fxliang/planck4x6/top_case.FCStd

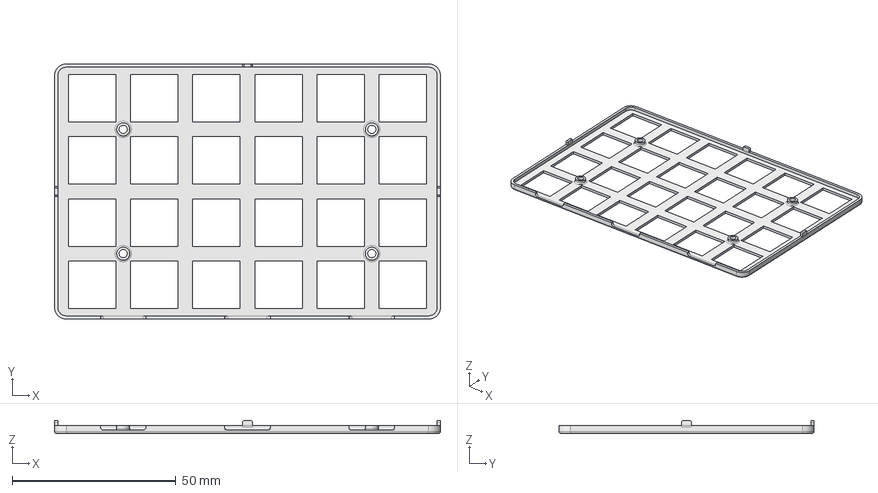
[picture p1: CAD file, 2023-02-18]
top_case.FCStd
118.0 x 78.0 x 3.90 mm
