fxliang/planck4x6/bottom_case.FCStd

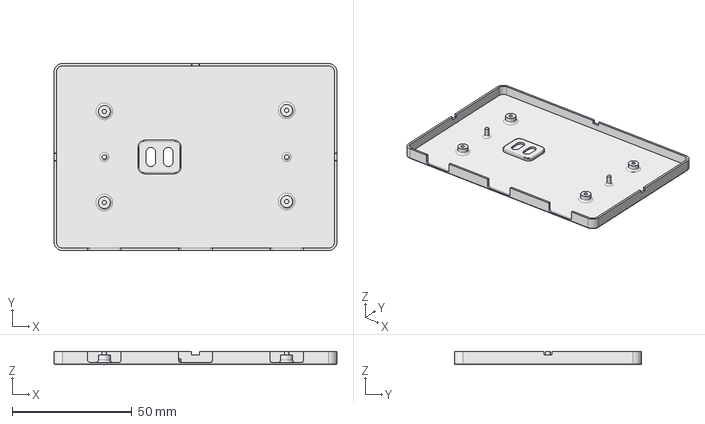
[picture p2: CAD file, 2023-02-18]
bottom_case.FCStd
118.0 x 78.0 x 5.60 mm
