fxliang/planck4x6/DHN-02F.STEP

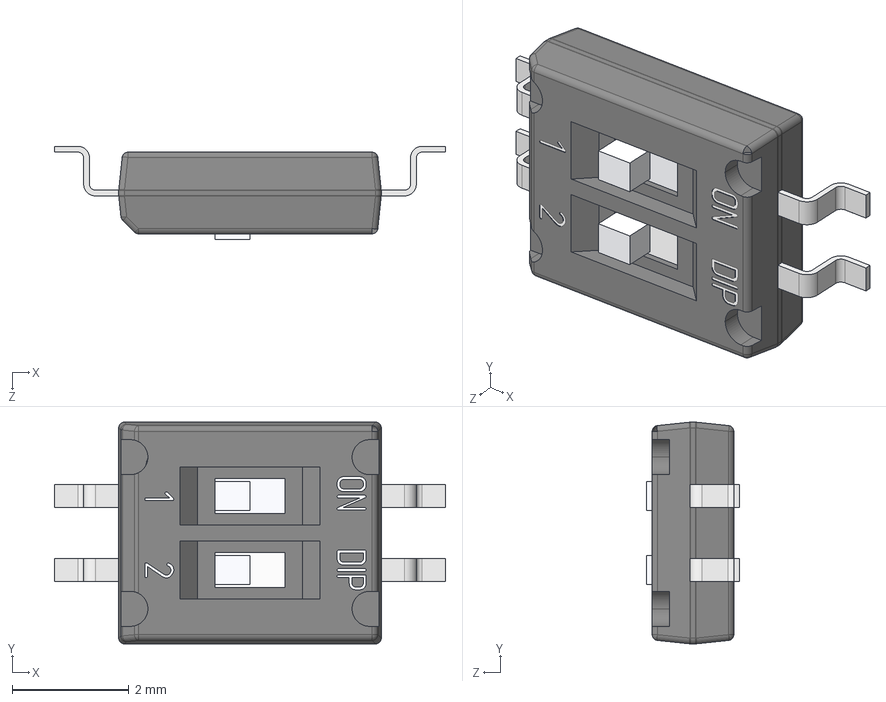
[picture p3: CAD file, 2023-02-17]
DHN-02F.STEP
6.70 x 3.80 x 1.60 mm
Open_CASCADE_STEP_translator_6.8_25.1
Open_CASCADE_STEP_translator_6.8_25.2.1
Leader x 4
