fxliang/planck4x6/MBK_Keycap_-_1u.step

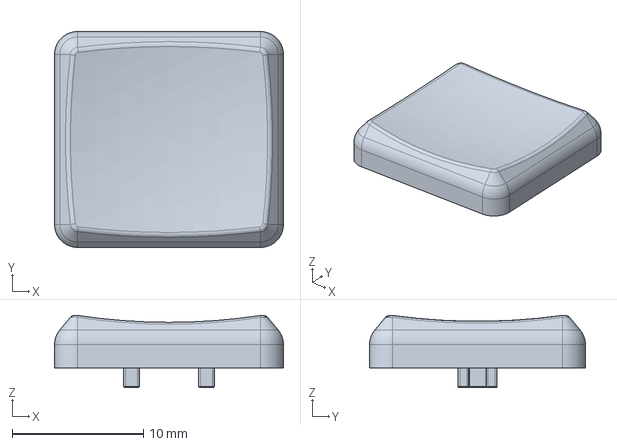
[picture p4: CAD file, 2023-02-17]
MBK_Keycap_-_1u.step
17.4 x 16.4 x 5.52 mm
