fxliang/planck4x6/SW_SPST_B3U-1000P.step

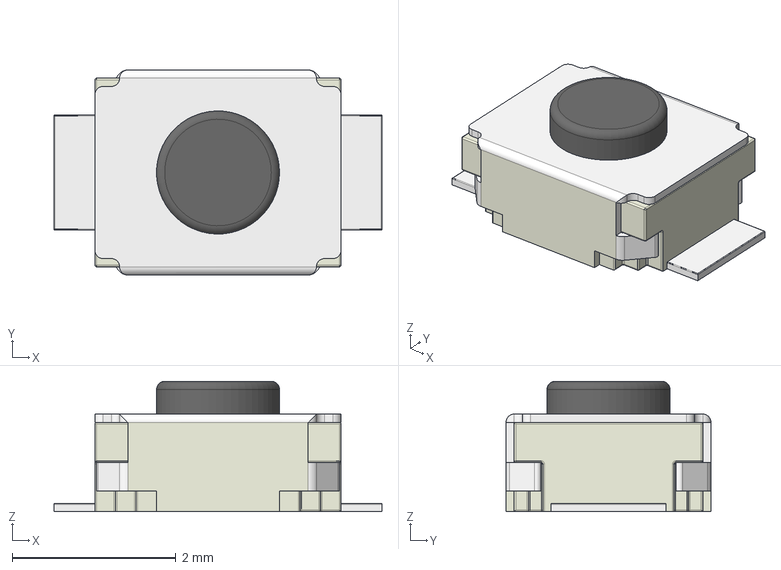
[picture p5: CAD file, 2023-02-17]
SW_SPST_B3U-1000P.step
4.00 x 2.50 x 1.59 mm
