fxliang/planck4x6/WS2812B.STEP

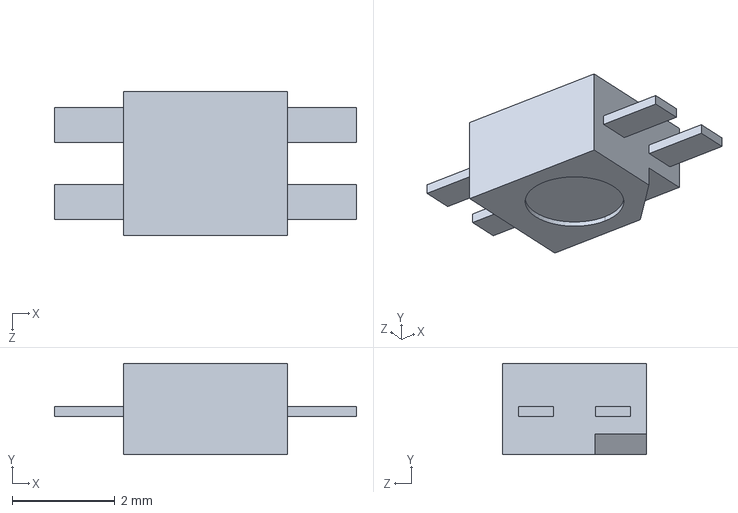
[picture p6: CAD file, 2023-02-13]
WS2812B.STEP
5.88 x 1.78 x 2.80 mm
