fxliang/planck4x6/TYPE-C-31-M-14.step

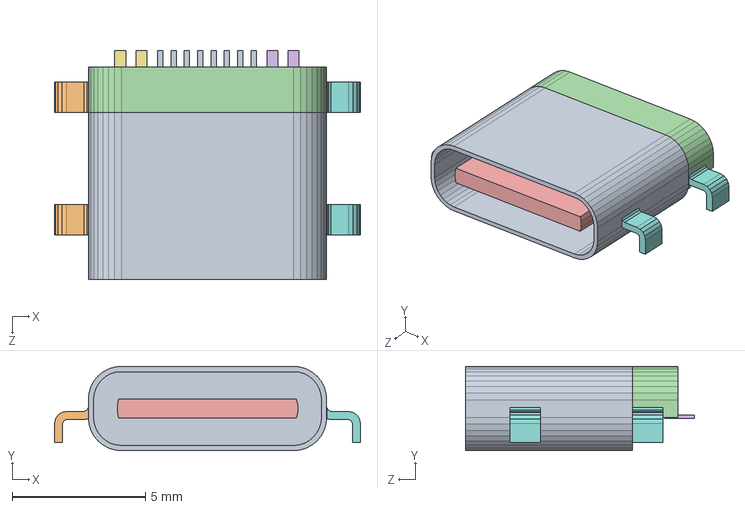
[picture p7: CAD file, 2023-02-10]
TYPE-C-31-M-14.step
11.5 x 3.16 x 8.58 mm
