fxliang/planck4x6/USON-8_3x2x0_55mm.STEP

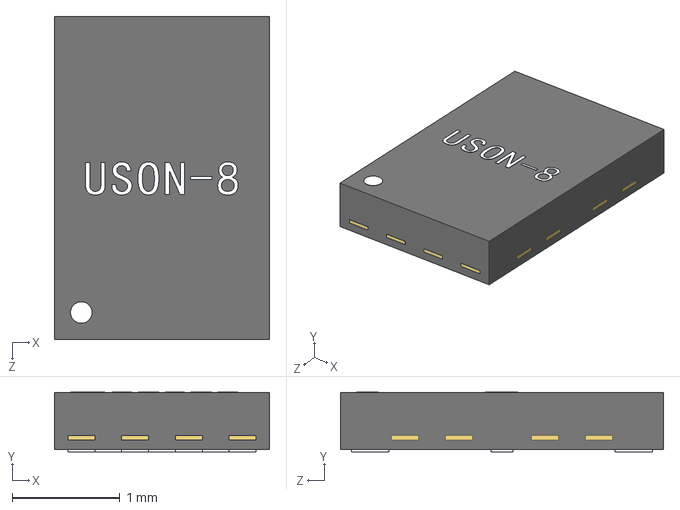
[picture p8: CAD file, 2023-02-10]
USON-8_3x2x0_55mm.STEP
2.00 x 0.553 x 3.00 mm
