fxliang/planck4x6/Switch_4x4x1.5MM.step

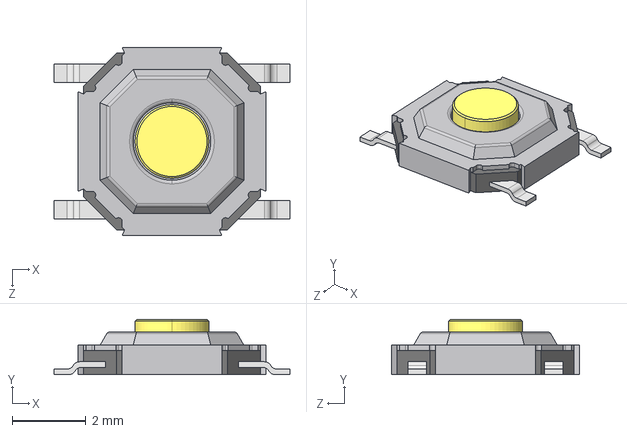
[picture p9: CAD file, 2023-02-10]
Switch_4x4x1.5MM.step
6.40 x 1.50 x 5.10 mm
