fxliang/planck4x6/C128990.STEP

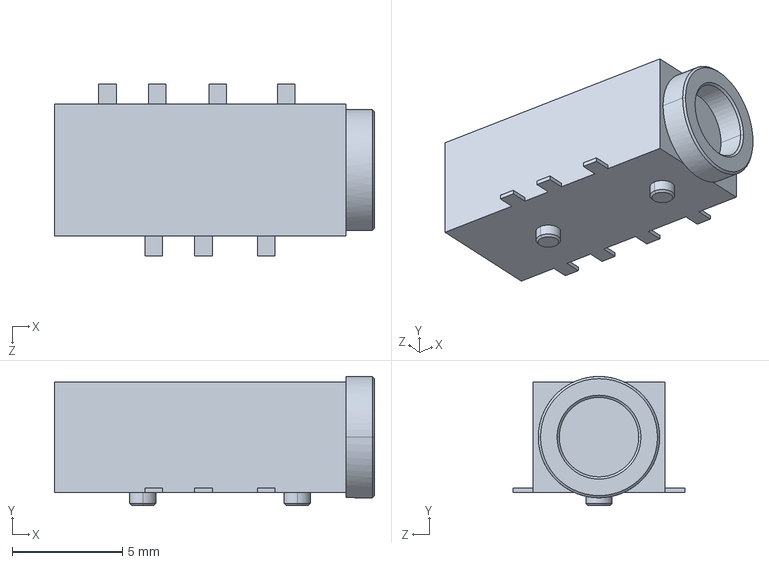
[picture p10: CAD file, 2023-02-07]
C128990.STEP
14.5 x 5.85 x 7.80 mm
