fxliang/planck4x6/(list of files, cad)

Other CAD files:
top_case-Part.step
bottom_case-Part.step
