fxliang/planck4x6/1457707425261.pdf

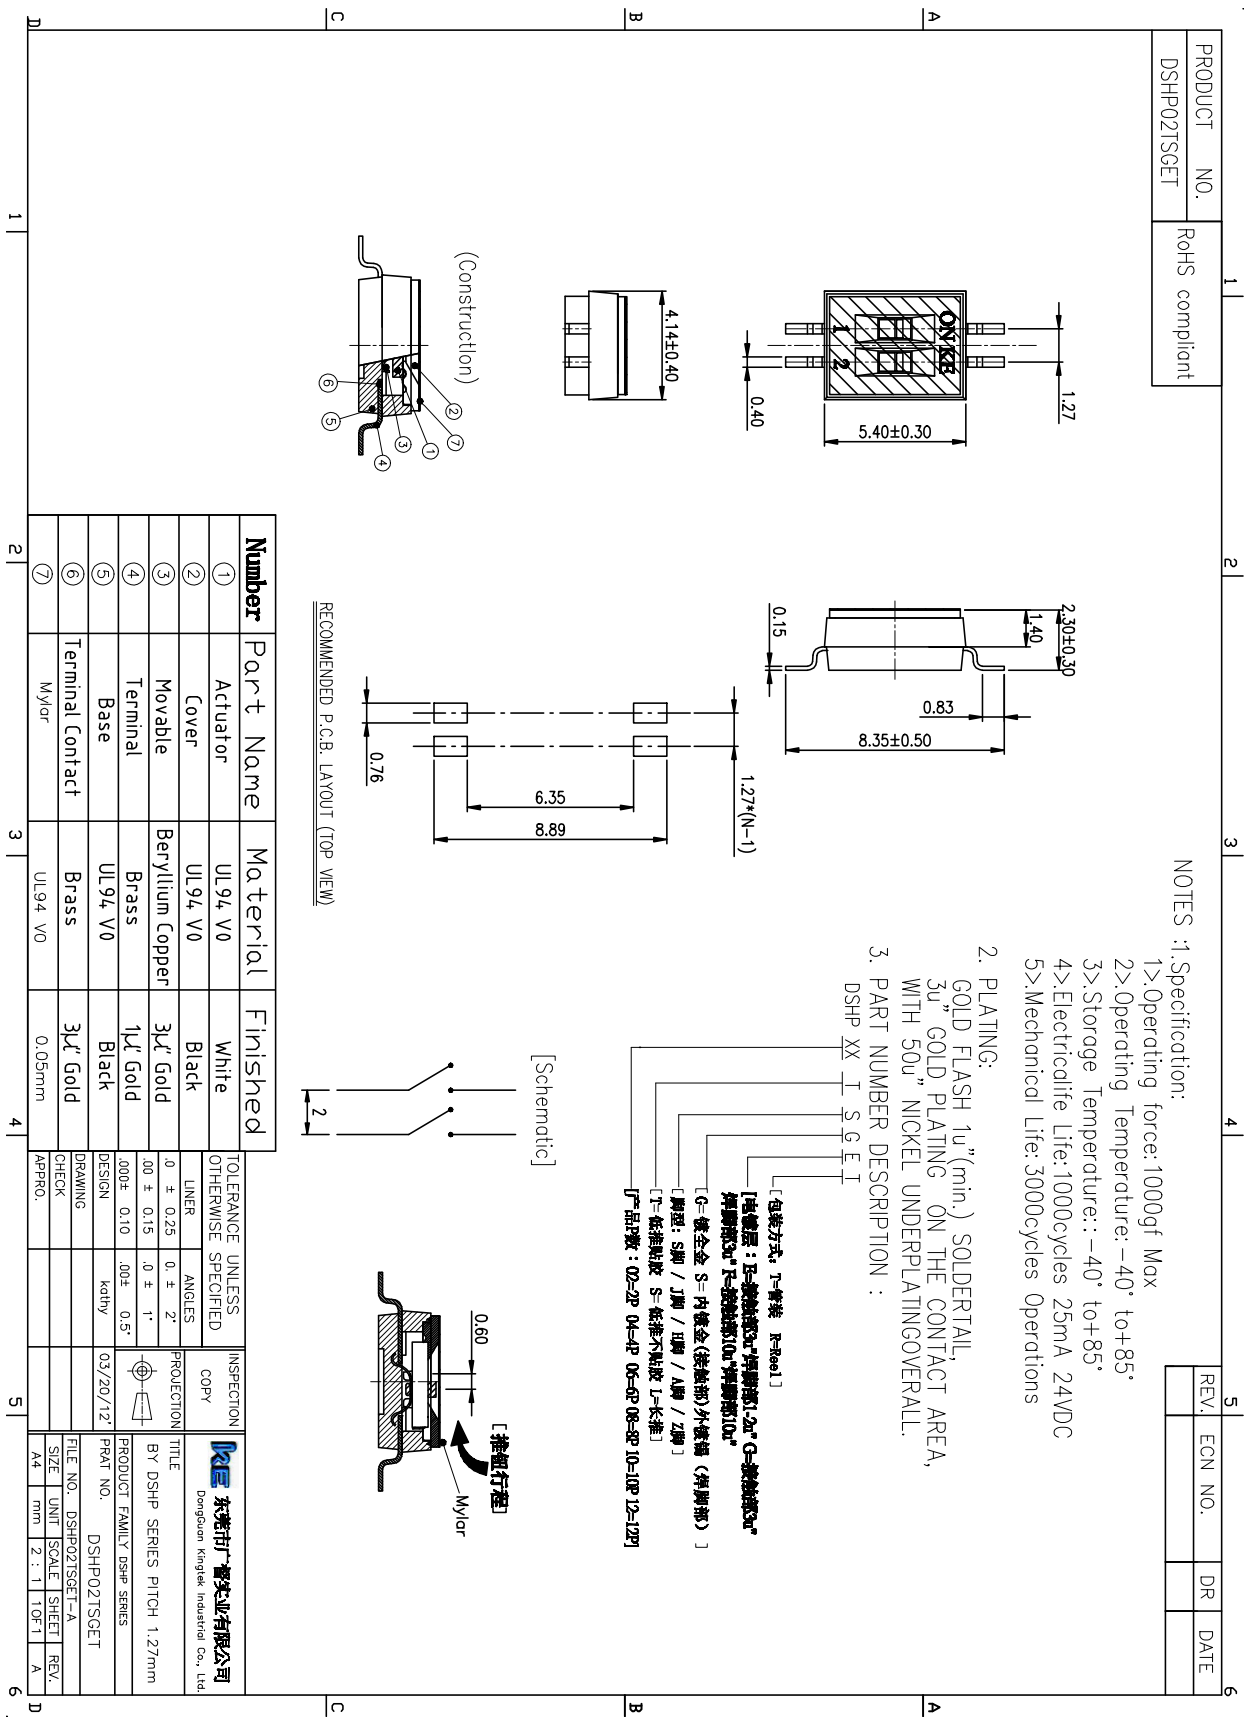
[picture p11: page 1]
