fxliang/planck4x6/planck.kicad_pcb

## KiCad design planck.kicad_pcb (2023-02-23)

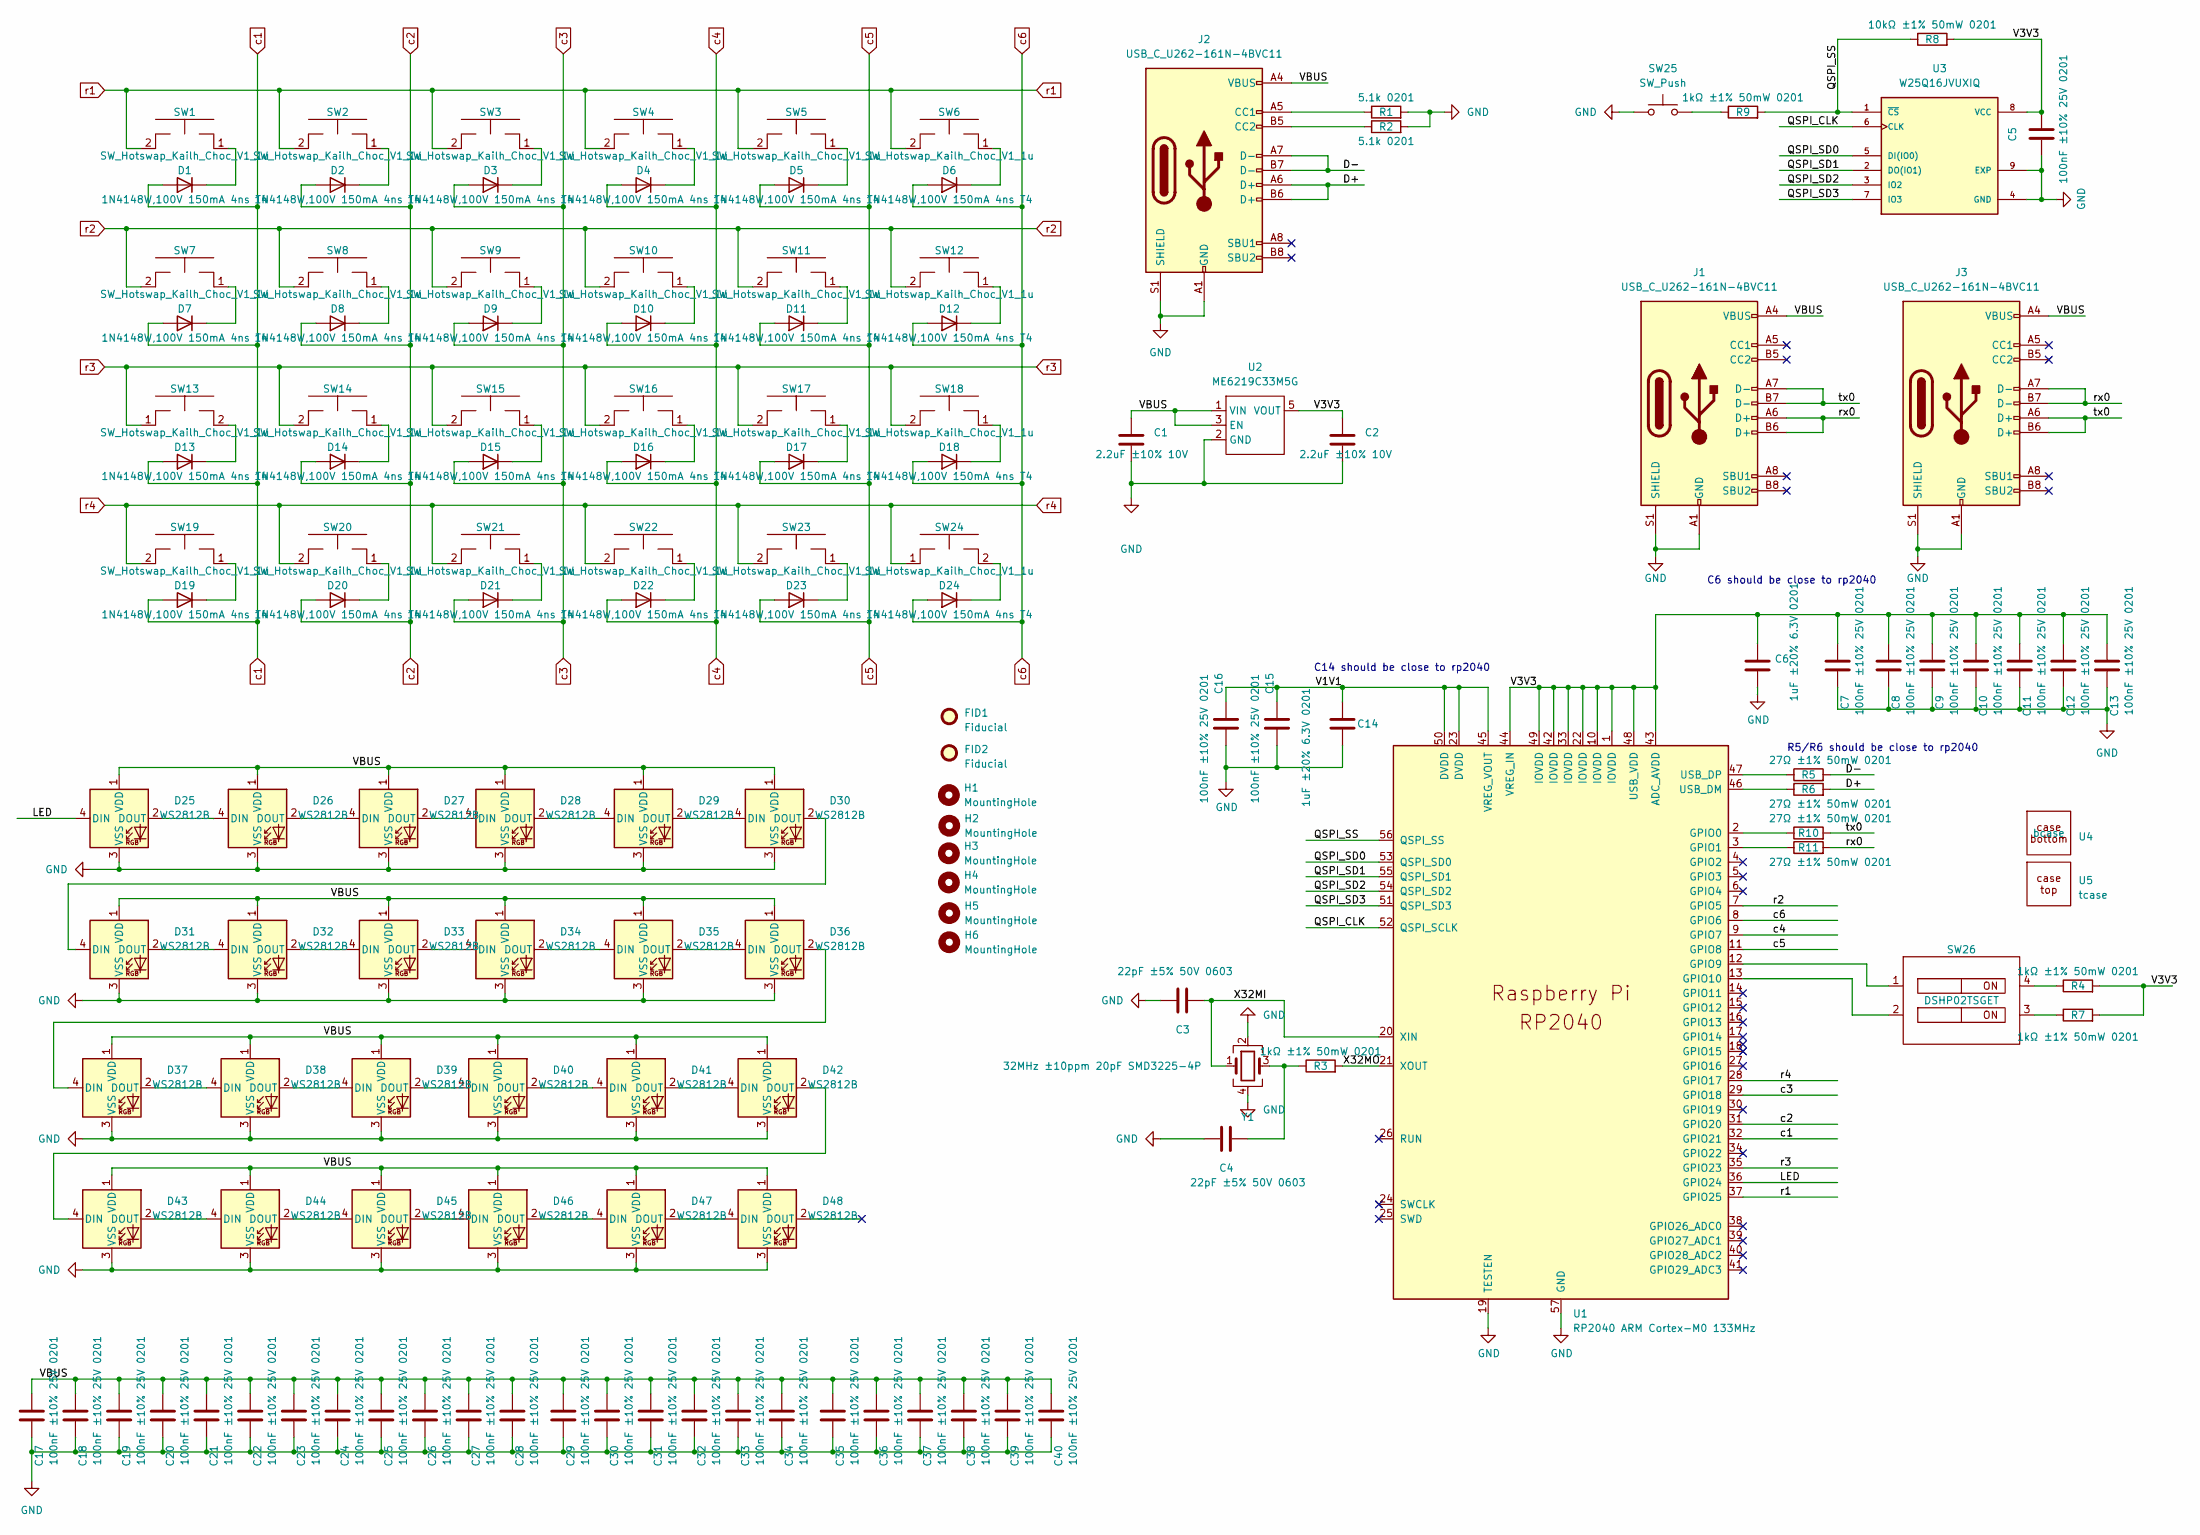
[picture p12: schematic planck.kicad_sch]

Parts:
C1, C2: 2.2uF ±10% 10V; R_0201_0603Metric; JLC C335106
C3, C4: 22pF ±5% 50V 0603; R_0201_0603Metric; JLC C76960
C5, C7, C8, C9, C10, C11, C12, C13, C15, C16, C17, C18, C19, C20, C21, C22, C23, C24, C25, C26, C27, C28, C29, C30, C31, C32, C33, C34, C35, C36, C37, C38, C39, C40: 100nF ±10% 25V 0201; R_0201_0603Metric; JLC C76939
C6, C14: 1uF ±20% 6.3V 0201; C_0201_0603Metric; JLC C87143
D1, D2, D3, D4, D5, D6, D7, D8, D9, D10, D11, D12, D13, D14, D15, D16, D17, D18, D19, D20, D21, D22, D23, D24: 1N4148W,100V 150mA 4ns T4; D_SOD-123; JLC C2099
D25, D26, D27, D28, D29, D30, D31, D32, D33, D34, D35, D36, D37, D38, D39, D40, D41, D42, D43, D44, D45, D46, D47, D48: WS2812B; WS2812_6028_REV_S
FID1, FID2: Fiducial; Fiducial_0.5mm_Mask1.5mm
H1, H2, H3, H4, H5, H6: MountingHole; MountingHole_2.2mm_M2
J1, J2, J3: USB_C_U262-161N-4BVC11; USB_C_TYPE-C-31-M-14; MPN U262-161N-4BVC11; JLC C223907
R1, R2: 5.1k 0201; R_0201_0603Metric; JLC C473460
R3, R4, R7, R9: 1kΩ ±1% 50mW 0201; R_0201_0603Metric; JLC C138165
R5, R6, R10, R11: 27Ω ±1% 50mW 0201; R_0201_0603Metric; JLC C273268
R8: 10kΩ ±1% 50mW 0201; R_0201_0603Metric; JLC C106225
SW1, SW2, SW3, SW4, SW5, SW6, SW7, SW8, SW9, SW10, SW11, SW12, SW13, SW14, SW15, SW16, SW17, SW18, SW19, SW20, SW21, SW22, SW23, SW24: SW_Hotswap_Kailh_Choc_V1_1u; SW_Hotswap_Kailh_Choc_V1
SW25: SW_Push; B3U-1000P; JLC C231329
SW26: DSHP02TSGET; JLC C40735
U1: RP2040 ARM Cortex-M0 133MHz; RP2040-QFN-56; JLC C2040
U2: ME6219C33M5G; SOT-23-5; JLC C47382
U3: W25Q16JVUXIQ; SON-8-1EP_3x2mm_P0.5mm_EP1.4x1.6mm; JLC C2843335
U4: bcase
U5: tcase
Y1: 32MHz ±10ppm 20pF SMD3225-4P; Crystal_SMD_3225-4Pin_3.2x2.5mm; JLC C164054

Connections:
/D+: J2.A6 (D+), J2.B6 (D+), R6.2
/D-: J2.A7 (D-), J2.B7 (D-), R5.2
/LED: D25.4 (DIN), U1.36 (GPIO24)
/QSPI_CLK: U1.52 (QSPI_SCLK), U3.6 (CLK)
/QSPI_SD0: U1.53 (QSPI_SD0), U3.5 (DI(IO0))
/QSPI_SD1: U1.55 (QSPI_SD1), U3.2 (DO(IO1))
/QSPI_SD2: U1.54 (QSPI_SD2), U3.3 (IO2)
/QSPI_SD3: U1.51 (QSPI_SD3), U3.7 (IO3)
/QSPI_SS: R8.1, R9.2, U1.56 (QSPI_SS), U3.1 (~CS)
/V1V1: C14.2, C15.1, C16.1, U1.23 (DVDD), U1.45 (VREG_VOUT), U1.50 (DVDD)
/V3V3: C2.1, C5.2, C6.1, C7.2, C8.2, C9.2, C10.2, C11.2, C12.2, C13.2, R4.2, R7.2, R8.2, U1.1 (IOVDD), U1.10 (IOVDD), U1.22 (IOVDD), U1.33 (IOVDD), U1.42 (IOVDD), U1.43 (ADC_AVDD), U1.44 (VREG_IN), U1.48 (USB_VDD), U1.49 (IOVDD), U2.5 (VOUT), U3.8 (VCC)
/VBUS: C1.1, C17.2, C18.2, C19.2, C20.2, C21.2, C22.2, C23.2, C24.2, C25.2, C26.2, C27.2, C28.2, C29.2, C30.2, C31.2, C32.2, C33.2, C34.2, C35.2, C36.2, C37.2, C38.2, C39.2, C40.2, D25.1 (VDD), D26.1 (VDD), D27.1 (VDD), D28.1 (VDD), D29.1 (VDD), D30.1 (VDD), D31.1 (VDD), D32.1 (VDD), D33.1 (VDD), D34.1 (VDD), D35.1 (VDD), D36.1 (VDD), D37.1 (VDD), D38.1 (VDD), D39.1 (VDD), D40.1 (VDD), D41.1 (VDD), D42.1 (VDD), D43.1 (VDD), D44.1 (VDD), D45.1 (VDD), D46.1 (VDD), D47.1 (VDD), D48.1 (VDD), J1.A4 (VBUS), J1.A9 (VBUS), J1.B4 (VBUS), J1.B9 (VBUS), J2.A4 (VBUS), J2.A9 (VBUS), J2.B4 (VBUS), J2.B9 (VBUS), J3.A4 (VBUS), J3.A9 (VBUS), J3.B4 (VBUS), J3.B9 (VBUS), U2.1 (VIN), U2.3 (EN)
/X32MI: C3.1, U1.20 (XIN), Y1.1
/X32MO: R3.2, U1.21 (XOUT)
/rx0: J1.A6 (D+), J1.B6 (D+), J3.A7 (D-), J3.B7 (D-), R11.2
/tx0: J1.A7 (D-), J1.B7 (D-), J3.A6 (D+), J3.B6 (D+), R10.2
GND: C1.2, C2.2, C3.2, C4.2, C5.1, C6.2, C7.1, C8.1, C9.1, C10.1, C11.1, C12.1, C13.1, C14.1, C15.2, C16.2, C17.1, C18.1, C19.1, C20.1, C21.1, C22.1, C23.1, C24.1, C25.1, C26.1, C27.1, C28.1, C29.1, C30.1, C31.1, C32.1, C33.1, C34.1, C35.1, C36.1, C37.1, C38.1, C39.1, C40.1, D25.3 (VSS), D26.3 (VSS), D27.3 (VSS), D28.3 (VSS), D29.3 (VSS), D30.3 (VSS), D31.3 (VSS), D32.3 (VSS), D33.3 (VSS), D34.3 (VSS), D35.3 (VSS), D36.3 (VSS), D37.3 (VSS), D38.3 (VSS), D39.3 (VSS), D40.3 (VSS), D41.3 (VSS), D42.3 (VSS), D43.3 (VSS), D44.3 (VSS), D45.3 (VSS), D46.3 (VSS), D47.3 (VSS), D48.3 (VSS), J1.A1 (GND), J1.A12 (GND), J1.B1 (GND), J1.B12 (GND), J1.S1 (SHIELD), J2.A1 (GND), J2.A12 (GND), J2.B1 (GND), J2.B12 (GND), J2.S1 (SHIELD), J3.A1 (GND), J3.A12 (GND), J3.B1 (GND), J3.B12 (GND), J3.S1 (SHIELD), R1.2, R2.2, SW25.1, U1.19 (TESTEN), U1.57 (GND), U2.2 (GND), U3.4 (GND), U3.9 (EXP), Y1.2, Y1.4
unnamed: C4.1, R3.1, Y1.3
unnamed: D1.1 (K), SW1.1
unnamed: D2.1 (K), SW2.1
unnamed: D3.1 (K), SW3.1
unnamed: D4.1 (K), SW4.1
unnamed: D5.1 (K), SW5.1
unnamed: D6.1 (K), SW6.1
unnamed: D7.1 (K), SW7.1
unnamed: D8.1 (K), SW8.1
unnamed: D9.1 (K), SW9.1
unnamed: D10.1 (K), SW10.1
unnamed: D11.1 (K), SW11.1
unnamed: D12.1 (K), SW12.1
unnamed: D13.1 (K), SW13.2
unnamed: D14.1 (K), SW14.1
unnamed: D15.1 (K), SW15.1
unnamed: D16.1 (K), SW16.1
unnamed: D17.1 (K), SW17.1
unnamed: D18.1 (K), SW18.1
unnamed: D19.1 (K), SW19.1
unnamed: D20.1 (K), SW20.1
unnamed: D21.1 (K), SW21.1
unnamed: D22.1 (K), SW22.1
unnamed: D23.1 (K), SW23.1
unnamed: D24.1 (K), SW24.2
unnamed: D25.2 (DOUT), D26.4 (DIN)
unnamed: D26.2 (DOUT), D27.4 (DIN)
unnamed: D27.2 (DOUT), D28.4 (DIN)
unnamed: D28.2 (DOUT), D29.4 (DIN)
unnamed: D29.2 (DOUT), D30.4 (DIN)
unnamed: D30.2 (DOUT), D31.4 (DIN)
unnamed: D31.2 (DOUT), D32.4 (DIN)
unnamed: D32.2 (DOUT), D33.4 (DIN)
unnamed: D33.2 (DOUT), D34.4 (DIN)
unnamed: D34.2 (DOUT), D35.4 (DIN)
unnamed: D35.2 (DOUT), D36.4 (DIN)
unnamed: D36.2 (DOUT), D37.4 (DIN)
unnamed: D37.2 (DOUT), D38.4 (DIN)
unnamed: D38.2 (DOUT), D39.4 (DIN)
unnamed: D39.2 (DOUT), D40.4 (DIN)
unnamed: D40.2 (DOUT), D41.4 (DIN)
unnamed: D41.2 (DOUT), D42.4 (DIN)
unnamed: D42.2 (DOUT), D43.4 (DIN)
unnamed: D43.2 (DOUT), D44.4 (DIN)
unnamed: D44.2 (DOUT), D45.4 (DIN)
unnamed: D45.2 (DOUT), D46.4 (DIN)
unnamed: D46.2 (DOUT), D47.4 (DIN)
unnamed: D47.2 (DOUT), D48.4 (DIN)
unnamed: J2.A5 (CC1), R1.1
unnamed: J2.B5 (CC2), R2.1
unnamed: R4.1, SW26.4
unnamed: R7.1, SW26.3
unnamed: R9.1, SW25.2
unnamed: R10.1, U1.2 (GPIO0)
unnamed: R11.1, U1.3 (GPIO1)
unnamed: SW26.1, U1.12 (GPIO9)
unnamed: SW26.2, U1.13 (GPIO10)
unnamed: R6.1, U1.46 (USB_DM)
unnamed: R5.1, U1.47 (USB_DP)
c1: D1.2 (A), D7.2 (A), D13.2 (A), D19.2 (A), U1.32 (GPIO21)
c2: D2.2 (A), D8.2 (A), D14.2 (A), D20.2 (A), U1.31 (GPIO20)
c3: D3.2 (A), D9.2 (A), D15.2 (A), D21.2 (A), U1.29 (GPIO18)
c4: D4.2 (A), D10.2 (A), D16.2 (A), D22.2 (A), U1.9 (GPIO7)
c5: D5.2 (A), D11.2 (A), D17.2 (A), D23.2 (A), U1.11 (GPIO8)
c6: D6.2 (A), D12.2 (A), D18.2 (A), D24.2 (A), U1.8 (GPIO6)
r1: SW1.2, SW2.2, SW3.2, SW4.2, SW5.2, SW6.2, U1.37 (GPIO25)
r2: SW7.2, SW8.2, SW9.2, SW10.2, SW11.2, SW12.2, U1.7 (GPIO5)
r3: SW13.1, SW14.2, SW15.2, SW16.2, SW17.2, SW18.2, U1.35 (GPIO23)
r4: SW19.2, SW20.2, SW21.2, SW22.2, SW23.2, SW24.1, U1.28 (GPIO17)

Notes on the sheet:
R5/R6 should be close to rp2040
C6 should be close to rp2040
C14 should be close to rp2040

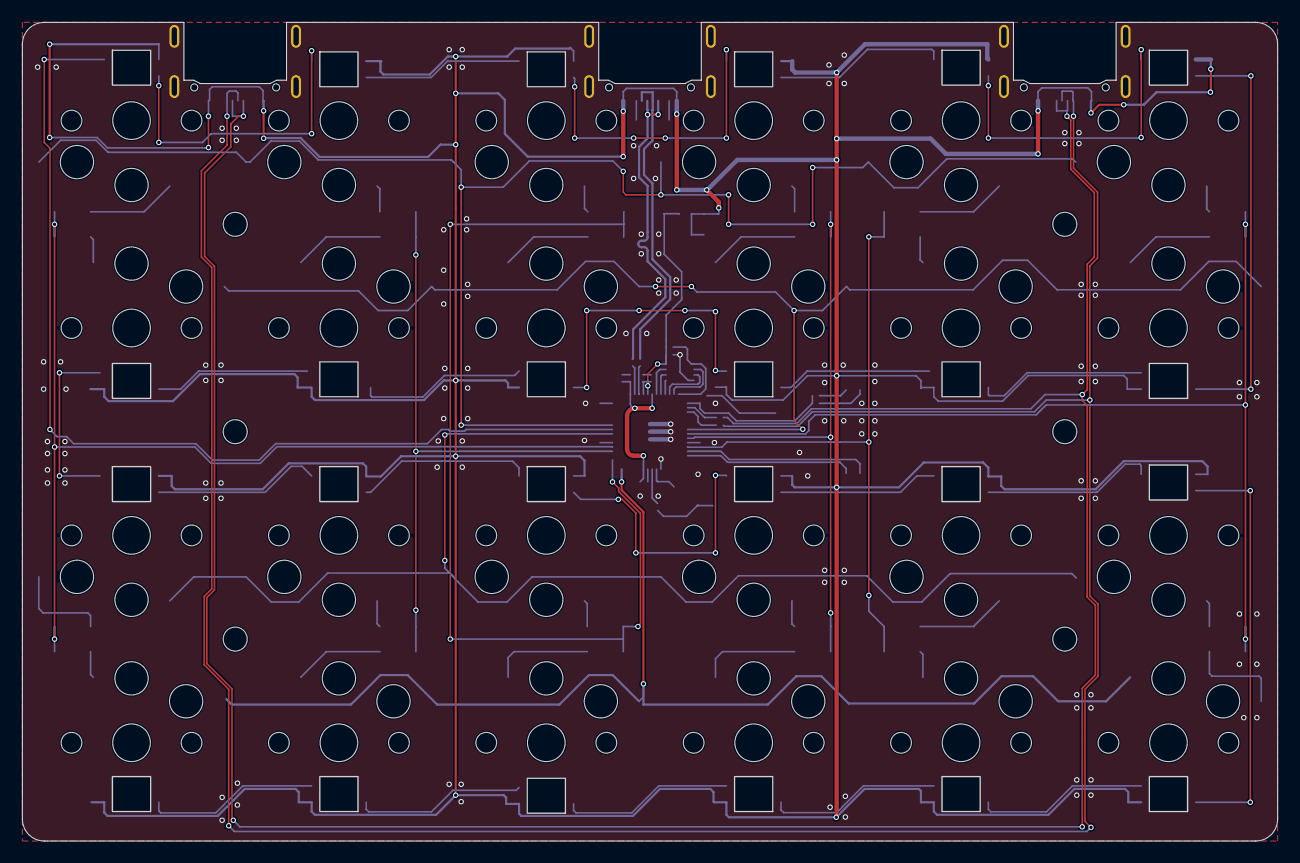
[picture p13: board planck.kicad_pcb from above]

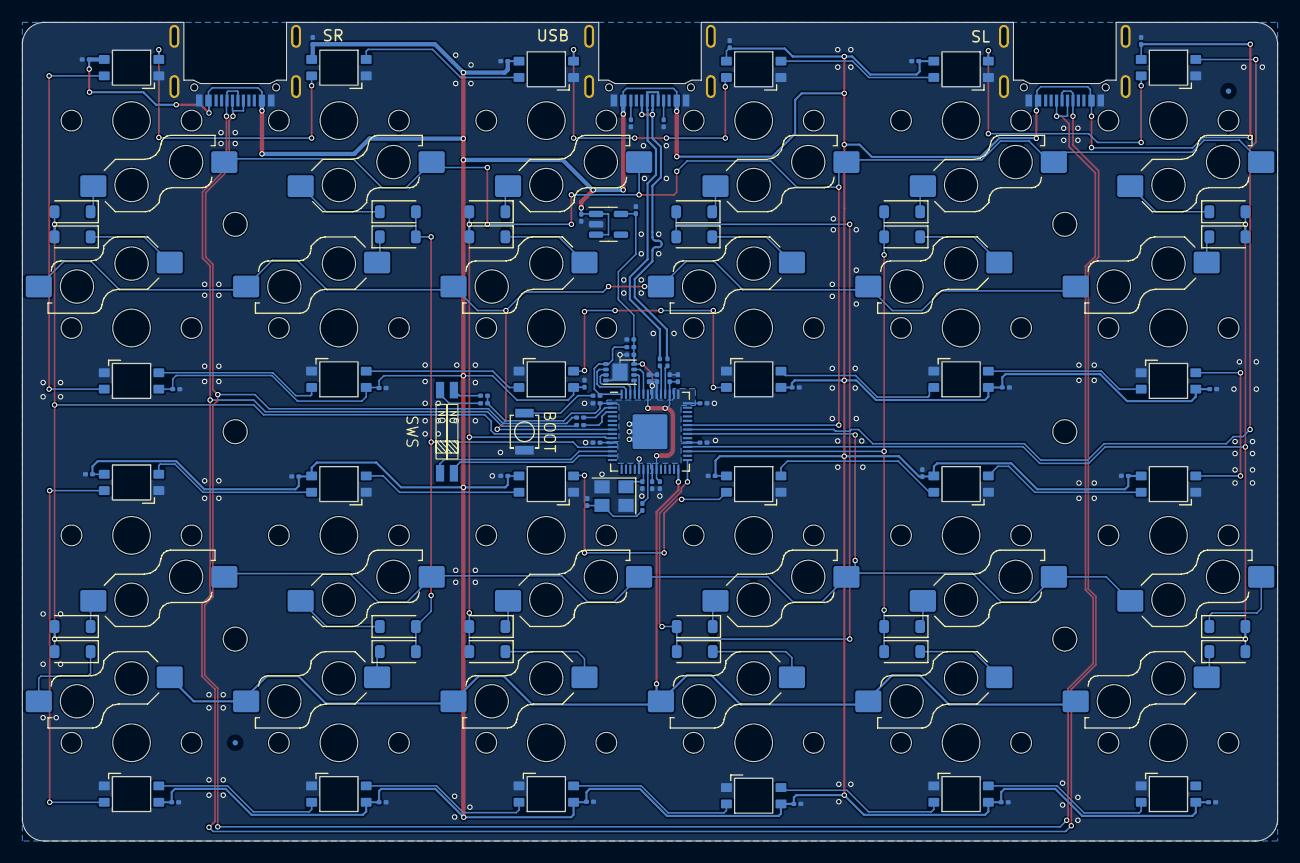
[picture p14: board planck.kicad_pcb from below]

Board: 2 copper layers, 115.0 x 75.0 mm, 142 parts (87 on the bottom side), 86 nets.
