fxliang/planck4x6/(commit log)

2023-02-07 first commit, key layout, usb/trrs layout.
    [C128990.STEP, planck.kicad_pcb, planck.kicad_sch, template.kicad_pcb, template.sch]
2023-02-09 some modifications
    [planck.kicad_pcb, planck.kicad_sch]
2023-02-10 MX version complete
    [Switch_4x4x1.5MM.step, TYPE-C-31-M-14.step, USON-8_3x2x0_55mm.STEP, planck.kicad_pcb, planck.kicad_sch]
2023-02-10 add libraries
    [planck.kicad_pcb]
2023-02-10 add choc libraries
    [planck.kicad_pcb, planck.kicad_sch]
2023-02-13 main layouts
    [WS2812B.STEP, planck.kicad_pcb, planck.kicad_sch]
2023-02-17 almost done
    [MBK_Keycap_-_1u.step, SW_SPST_B3U-1000P.step, planck.kicad_pcb, planck.kicad_sch]
2023-02-17 ADD SWITCH HANDSET
    [DHN-02F.STEP, planck.kicad_pcb, planck.kicad_sch]
2023-02-17 hide switch print
    [planck.kicad_pcb]
2023-02-18 connect LED, add case
    [bottom_case-Part.step, bottom_case.FCStd, planck.kicad_pcb, planck.kicad_sch, top_case-Part.step, top_case.FCStd]
2023-02-18 filet top case
    [top_case-Part.step, top_case.FCStd]
2023-02-21 distance check add serial resistor for protection
    [planck.kicad_pcb, planck.kicad_sch]
2023-02-23 little layout modification resistor over serial for protection 27R
    [planck.kicad_pcb, planck.kicad_sch]
